Parzival129/protean/media/early-lcd.jpg

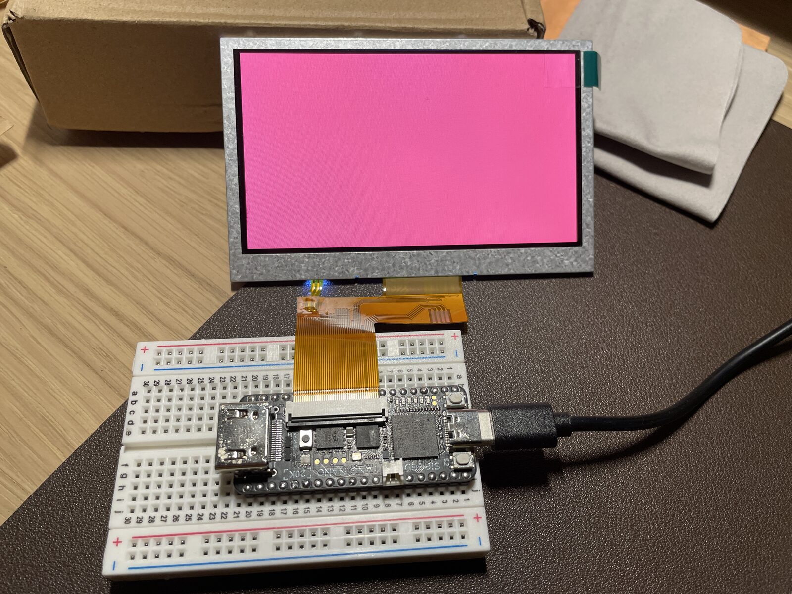
media/early-lcd.jpg
