Parzival129/protean/media/gameboy-boot.jpg

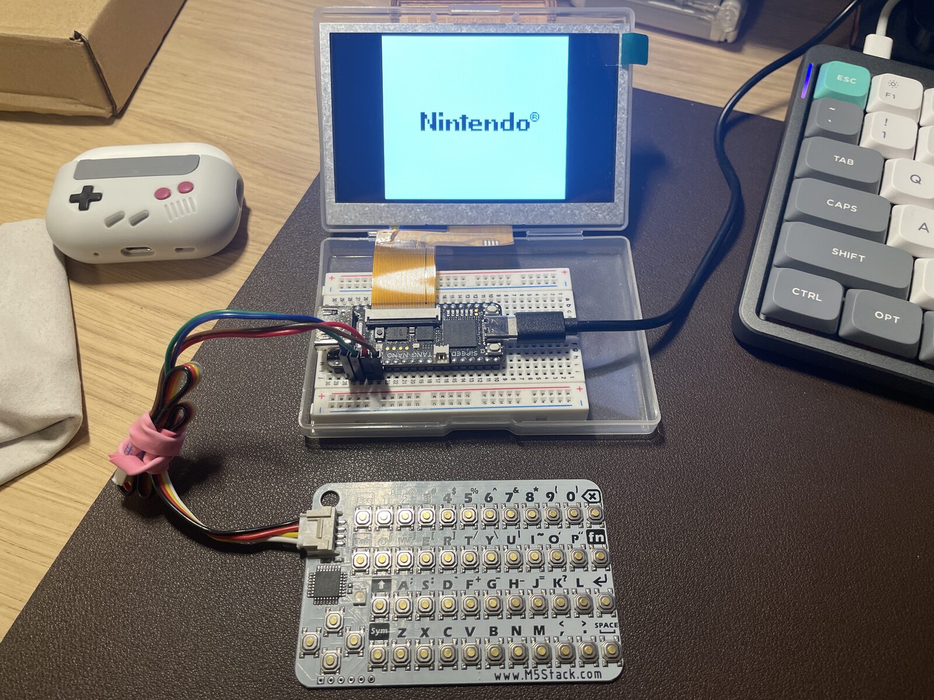
media/gameboy-boot.jpg
