Parzival129/protean/media/logic-analyzer.jpg

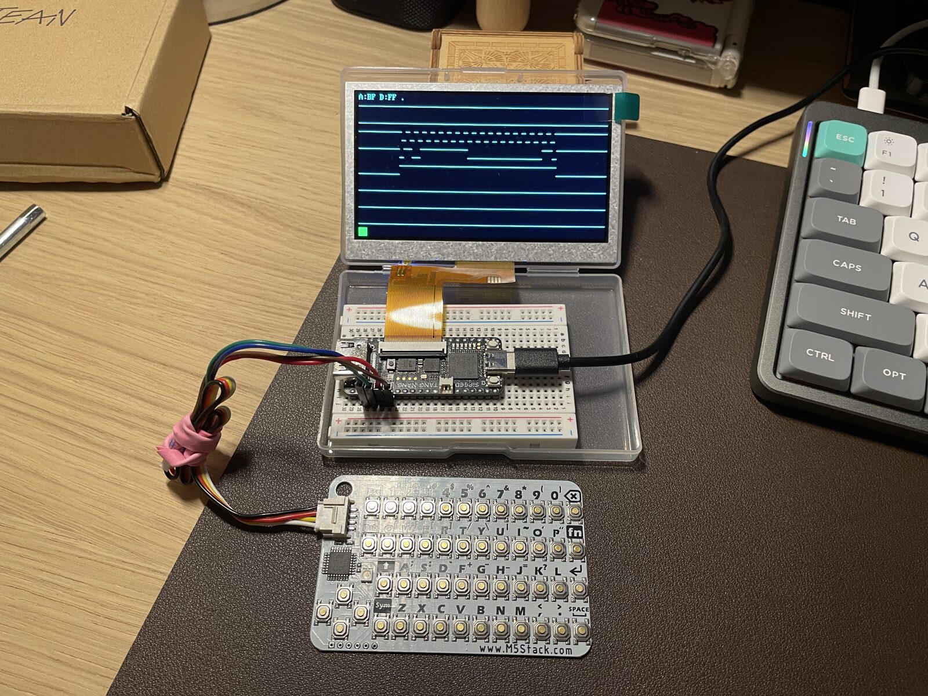
media/logic-analyzer.jpg
