Parzival129/protean/media/tetris-gameover.jpg

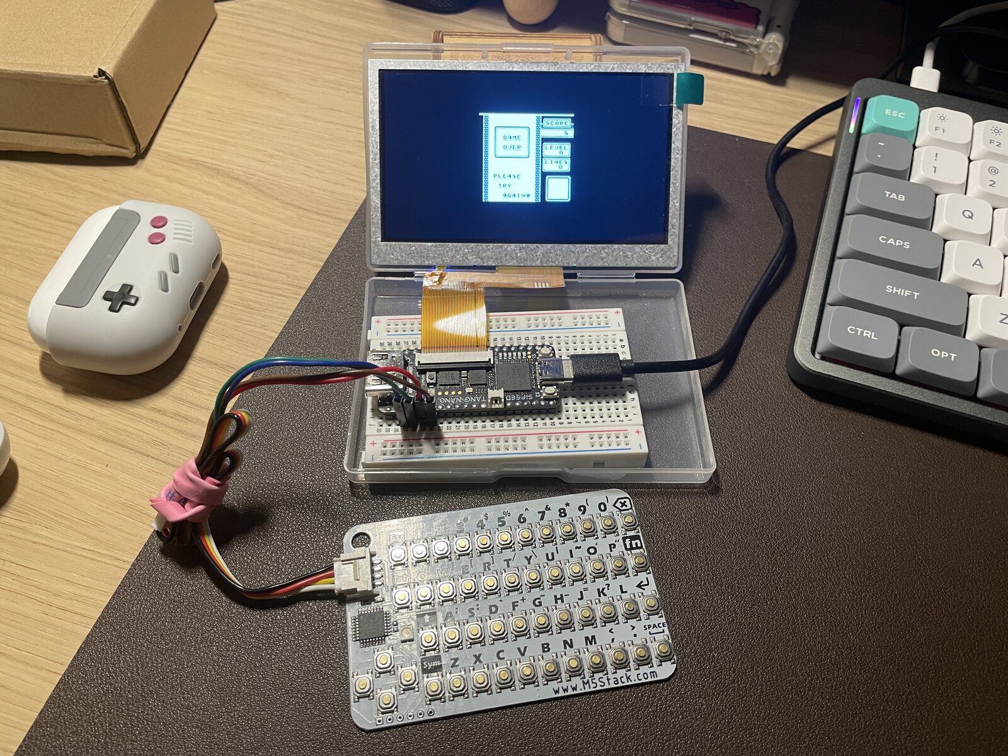
media/tetris-gameover.jpg
