Parzival129/protean/(commit log)

2026-07-11 finished first version of SPI byte engine
2026-07-14 Created first test of spi controller module, tested communication with flash module, confirmed working.
2026-08-02 Full 'on-fabric' FPGA switching finally achieved! Can switch from one fabric bitstream to another per a button press.
2026-08-02 Added full fabric selector flow through on-board buttons
2026-08-02 added fallback self heal mechanism in case checksum fails for persona fabric flash
2026-08-10 Added proper 2d grid menu with persona selection via button press
2026-08-11 Got I2C keyboard connected and working with fabric switching menu, also refactored project structure
2026-08-14 started base sampler, capture and trigger rtl for logic analyzer persona with ai gen testbenches
2026-08-14 fixed current to previous bit on trigger
    [trigger.v]
2026-08-21 Got full re-arming / sampling for logic analyzer working, currentely just probing button input
2026-08-22 Got a live re-arm system with circular recording to remember pre-trigger data, and zoom setup
2026-08-22 Got full return to shell from persona interface working. Wired up flash module in logic analyzer to reload fabric
2026-08-24 Full i2c master module built for reading from CardKB with RTL
2026-08-25 got keyboard control working for the logic analyzer, only after immense debugging with the RTL i2c module cycling issues
    [i2c_master.v, la_top.v]
2026-08-25 Got i2c decode module complete and tested
2026-08-25 Full i2c decoder and key decoder working on screen with pan, zoom, and transaction recognition
2026-08-27 Finished gb_video showing a picture on screen (still glitching) and updated gb_clock to use global clock tree
    [gb_clock.v, gb_video.v, gb_video_tb.v]
2026-08-27 Fixed display issues by detecting for rising edge on vs and hs from core, displaying perfectly now
    [gb_video.v]
2026-08-27 Added switching capability from GB back to shell and extended shell to include GB, full user cycle proven
2026-09-01 cocotb test working for i2c read address and ack from slave
2026-09-02 got pyuvm stack working on RTL, transaction flows seq, sequncr, driver, DUT
2026-09-03 Full UVM flow proven on non-randomized transactions, added scoreboard, monitor
2026-09-03 Added coverage checking for i2c verif
2026-09-03 updated readme to current state of project including verification
